TheByteAttic/Hazeltine-1420-CharGen-Firmware/images/README.md

# Images

Photos used in the READMEs. All of the author's terminal (Hazeltine 1420, 1979 board).

| File | Shows |
|---|---|
| `terminal-board-overview.jpg` | the complete logic board after restoration, keyboard in front |
| `adapters-installed.jpg` | the two character-generator adapters in U25/U26, seen from above |
| `adapters-installed-angle.jpg` | the same, at an angle, with the firmware ROMs and the CPU below them |
| `adapters-top.jpg` | the two assembled adapters, EEPROM side (rev A boards, jumpers bridged) |
| `adapters-bottom.jpg` | the two assembled adapters, logic side |
| `boards-as-delivered.jpg` | bare boards from JLCPCB next to assembled ones |
| `original-p8049-and-roms.jpg` | the original Intel P8049 CPU with the replacement 2716 EPROMs in U10/U11 |
| `cpu-upd8749hd.jpg` | the NEC uPD8749HD fitted as CPU, programmed with the 8049 image |
