TheByteAttic/Hazeltine-1420-CharGen-Firmware/H1420-chargen-adapter/hardware/images/README.md

# Images

All generated from the manufacturing data, not from a CAD screenshot.

| File | View |
|---|---|
| `render-U26-upper-top.png`, `render-U26-upper-bottom.png` | U26-upper board as manufactured, top and bottom (bottom seen from below), drill holes black |
| `render-U25-lower-top.png`, `render-U25-lower-bottom.png` | same for the U25-lower board |
| `tracks-*-top-layer.png`, `tracks-*-bottom-layer.png` | one copper layer at a time, without the ground pour, for following individual nets |
| `preview-U26-upper.png`, `preview-U25-lower.png` | layout overview with reference designators |
