TheByteAttic/Hazeltine-1420-CharGen-Firmware/H1420-chargen-adapter/hardware/schematic.pdf

Hazeltine 1420 character-generator adapter, rev B (replaces DM8678 / DM86S64 at U25 / U26)

net-label schematic: pins carrying the same label are connected. Two board variants (U26 upper / U25 lower) share this circuit.

P1 plug into DM8678 / DM86S64 socket (U25 / U26)

ADR2 | 1 A2/A3
ADR1 | 2 A1/A2
ADR0 | 3 A0/A1
ALC | 4 ADDR LATCH
nCLR | 5 /CLEAR
LCLK | 6 LINE CLOCK
CC | 7 CLOCK CTRL
GND | 8 GND
VCC 16 | VCC
A3/A4 15 | ADR3
A4/A5 14 | ADR4
A5/A6 13 | ADR5
A7|OUT 12 | PIN12
OUT|/OE 11 | PIN11
/LOAD 10 | nLD
DOT CLOCK 9 | DCLK

pin 11 = video OUT, pin 12 = A7 / enable, active low (same on both chips, measured)

U1 74HCT373 address latch

ADR0 | 3 D0
ADR1 | 4 D1
ADR2 | 7 D2
ADR3 | 8 D3
ADR4 | 13 D4
ADR5 | 14 D5
PIN12 | 17 D6
GND | 18 D7
ALC | 11 LE
GND | 1 /OE
GND | 10 GND
Q0 2 | LA0
Q1 5 | LA1
Q2 6 | LA2
Q3 9 | LA3
Q4 12 | LA4
Q5 15 | LA5
Q6 16 | LA7
Q7 19 | NC
VCC 20 | VCC

U2 74HCT161 line counter

LCLK | 2 CP
nCLR | 1 /MR
CC | 7 CEP
VCC | 10 CET
VCC | 9 /PE
GND | 3 D0
GND | 4 D1
GND | 5 D2
GND | 6 D3
GND | 8 GND
Q0 14 | ROW0
Q1 13 | ROW1
Q2 12 | ROW2
Q3 11 | ROW3
TC 15 | NC
VCC 16 | VCC

U5 AT28C64B font EEPROM (DIP-28 socket)

LA0 | 10 A0
LA1 | 9 A1
LA2 | 8 A2
LA3 | 7 A3
LA4 | 6 A4
LA5 | 5 A5
ROW0 | 4 A6
ROW1 | 3 A7
ROW2 | 25 A8
ROW3 | 24 A9
GND | 21 A10
GND | 23 A11
GND | 2 A12
GND | 20 /CE
GND | 22 /OE
GND | 14 GND
D0 11 | D0
D1 12 | D1
D2 13 | D2
D3 15 | D3
D4 16 | D4
D5 17 | D5
D6 18 | D6
D7 19 | NC
VPP/RDY/A15 1 | PU1
NC/A13 26 | PU26
/WE//PGM/A14 27 | PU27
VCC 28 | VCC

U3 74HCT166 dot shift register

D0 | 14 H
D1 | 12 G
D2 | 11 F
D3 | 10 E
D4 | 5 D
D5 | 4 C
D6 | 3 B
GND | 2 A
GND | 1 SER
DCLK | 7 CLK
nLD | 15 SH//LD
GND | 6 CLK INH
VCC | 9 /CLR
GND | 8 GND
QH 13 | SER
VCC 16 | VCC

U4 74HCT125 tri-state output

SER | 2 1A
LA7 | 1 /1OE
GND | 5 2A
GND | 4 /2OE
GND | 9 3A
GND | 10 /3OE
GND | 12 4A
GND | 13 /4OE
GND | 7 GND
1Y 3 | PIN11
2Y 6 | NC
3Y 8 | NC
4Y 11 | NC
VCC 14 | VCC
R1, R2, R3 | 1 kOhm 0805 | VCC -> U5 pin 1, 26, 27 | (nets PU1, PU26, PU27): keep /WE high on a 28C64,

set A13/A14/A15 high on a 27C256/27C512 (image block replicated, see build_eeprom.py)

C1..C5 | 100 nF 0805 decoupling, one per IC (VCC-GND)
Rev B: no jumpers. | Video out U4 pin 3 -> socket pin 11 (net PIN11); latched socket pin 12 (A7) -> U4 pin 1 /OE (net LA7).

(Rev A had solder jumpers JP1/JP2 for a DM86S64 pin assignment that turned out to be the same as the DM8678 one;

rev A boards are used with JP1 C-A and JP2 C-A bridged, which is exactly this wiring.)

Output enable polarity: U4 = 74HCT125 -> output active when latched pin 12 is LOW, as measured on both original chips.

If the font dump of a chip shows it outputs when pin 12 is HIGH, fit a 74HCT126 instead (same pinout, active-high enable).

Logic family: 74HCT (TTL-compatible inputs, VIH = 2.0 V). | The terminal drives the socket with 74LS outputs (VOH >= 2.7 V),
which plain 74HC (VIH = 3.5 V) would not reliably read. | Do not substitute 74HC for U1-U4.

Timing: address -> latch (74HCT373, ~25 ns) -> EEPROM (150 ns) -> 74HC166 setup: ~190 ns < 280 ns spec of the

original (t_S2). Dot clock up to 25 MHz with 74HCT166; Hazeltine 1420 dot clock is below 20 MHz.

Row address: the 74HC161 replaces the on-chip mod-16 line counter (CP = line clock, CEP = clock control,

/MR = /clear). Descender shifting of the original is baked into the EEPROM image row by row.

Shift register: /LOAD -> SH//LD; DOT CLOCK -> CLK; EEPROM D0 (first dot) -> H ... D6 -> B; A and SER = 0,

so the output goes low after the 7 dots exactly like the original.

Copyright (c) 2026 by The Byte Attic B.V.
