TheByteAttic/Hazeltine-1420-CharGen-Firmware/H1420-Bitsavers-firmware/h1420_descr.jpg

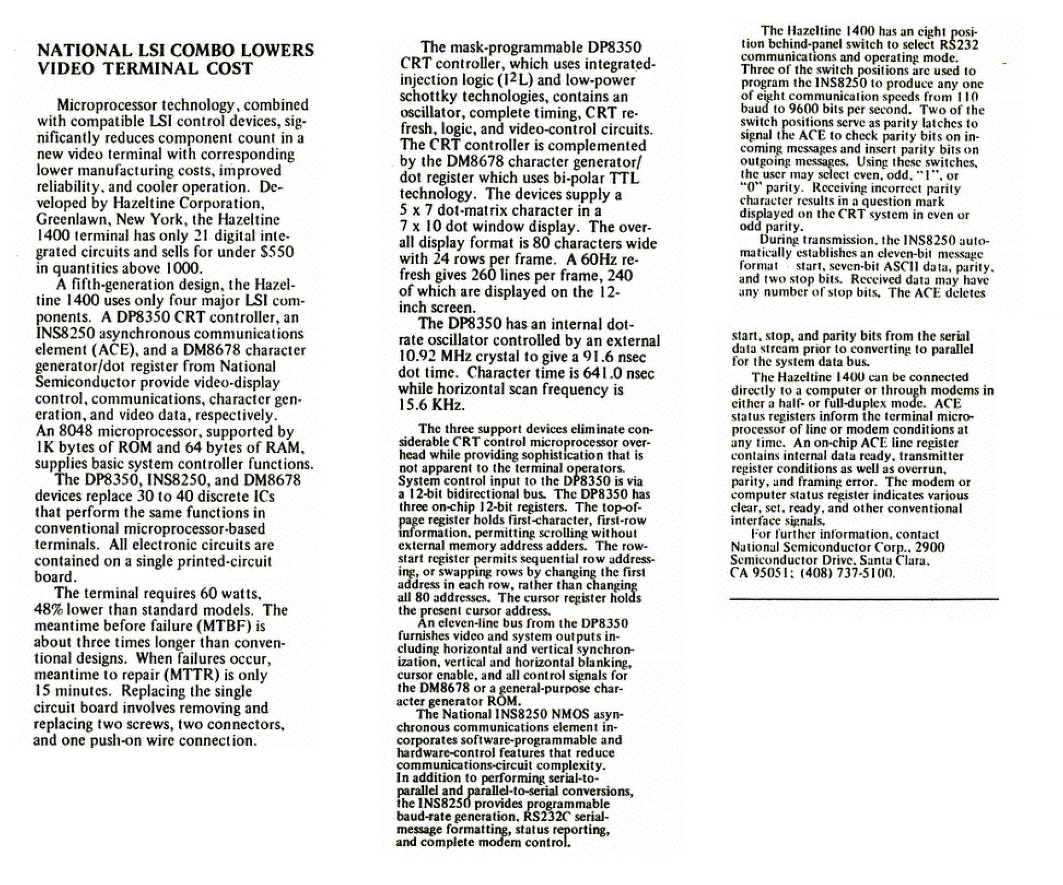
H1420-Bitsavers-firmware/h1420_descr.jpg
