TheByteAttic/Hazeltine-1420-CharGen-Firmware/H1420-Bitsavers-firmware/pcb3.jpg

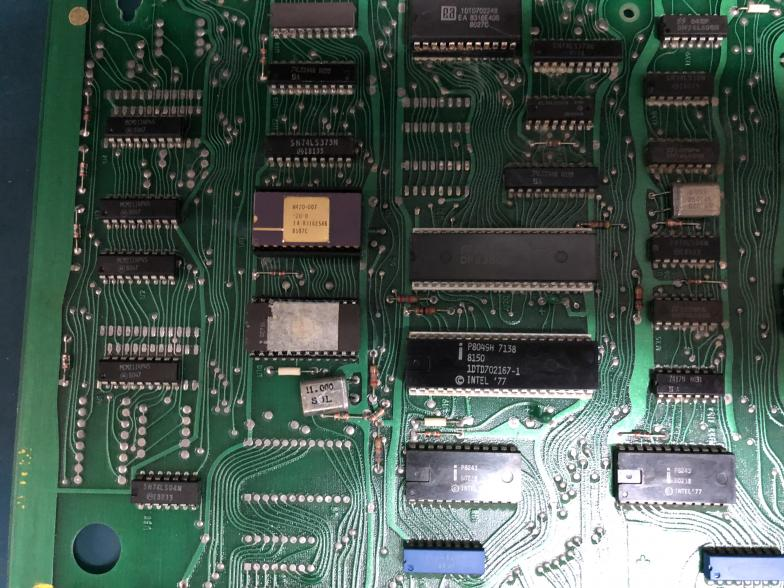
H1420-Bitsavers-firmware/pcb3.jpg
