TheByteAttic/Hazeltine-1420-CharGen-Firmware/H1420-chargen-adapter/hardware/images/preview-U26-upper.png

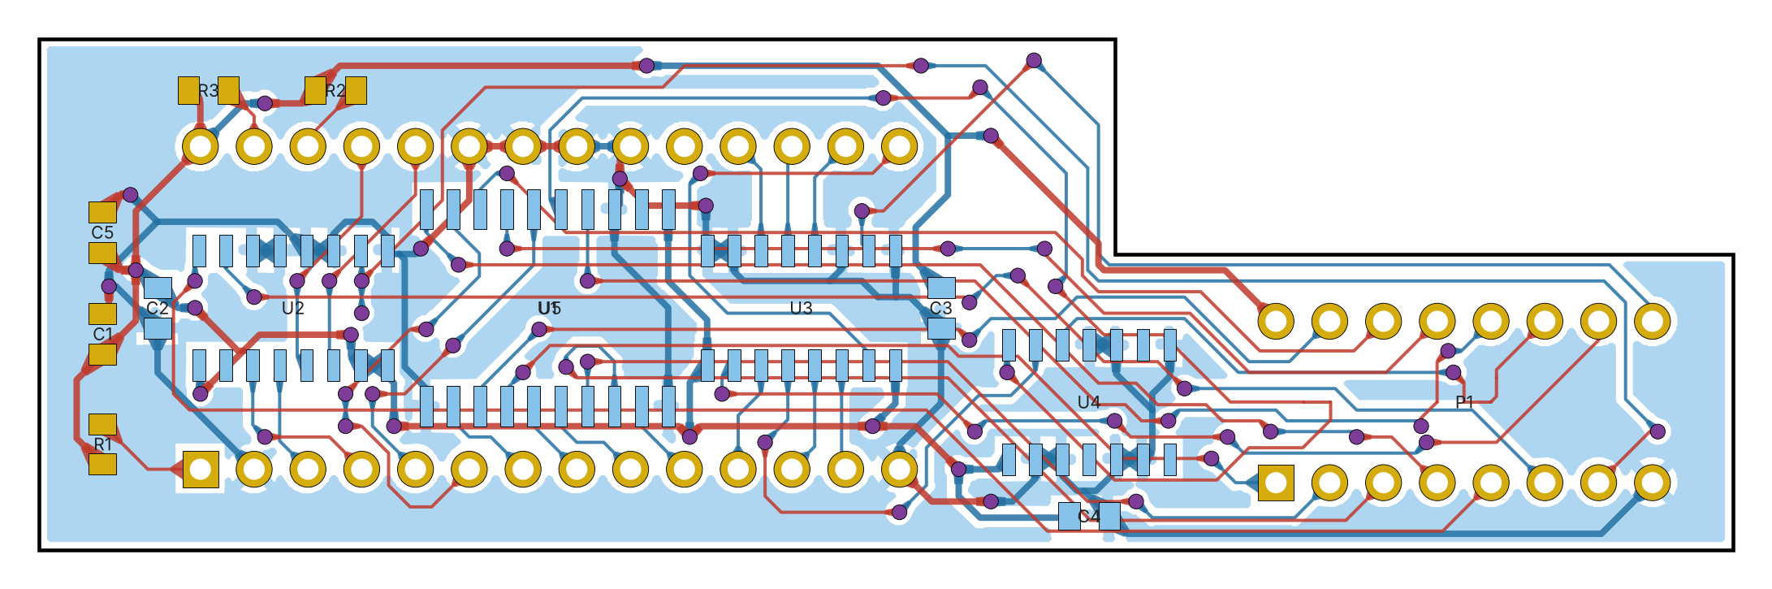
H1420-chargen-adapter/hardware/images/preview-U26-upper.png
