TheByteAttic/Hazeltine-1420-CharGen-Firmware/H1420-chargen-adapter/hardware/images/render-U26-upper-bottom.png

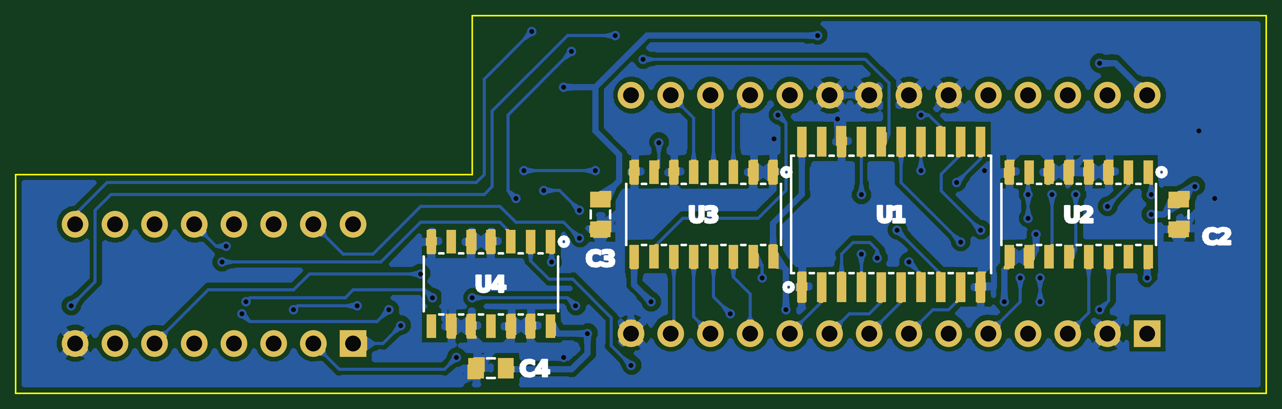
H1420-chargen-adapter/hardware/images/render-U26-upper-bottom.png
