TheByteAttic/Hazeltine-1420-CharGen-Firmware/H1420-chargen-adapter/hardware/images/tracks-U26-upper-top-layer.png

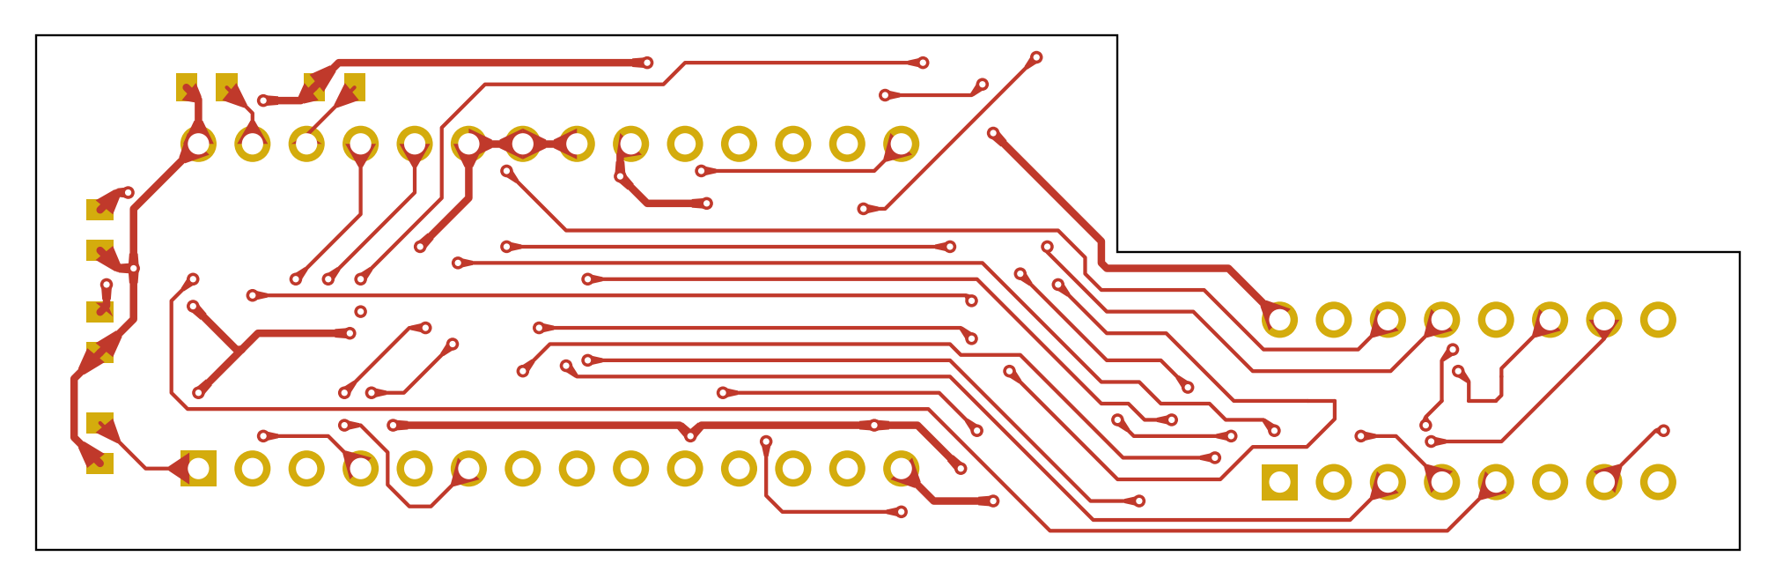
H1420-chargen-adapter/hardware/images/tracks-U26-upper-top-layer.png
