TheByteAttic/Hazeltine-1420-CharGen-Firmware/H1420-chargen-adapter/hardware/kicad/h1420-chargen-U26-upper.kicad_pcb

## KiCad design H1420-chargen-adapter/hardware/kicad/h1420-chargen-U26-upper.kicad_pcb (2026-11-02)

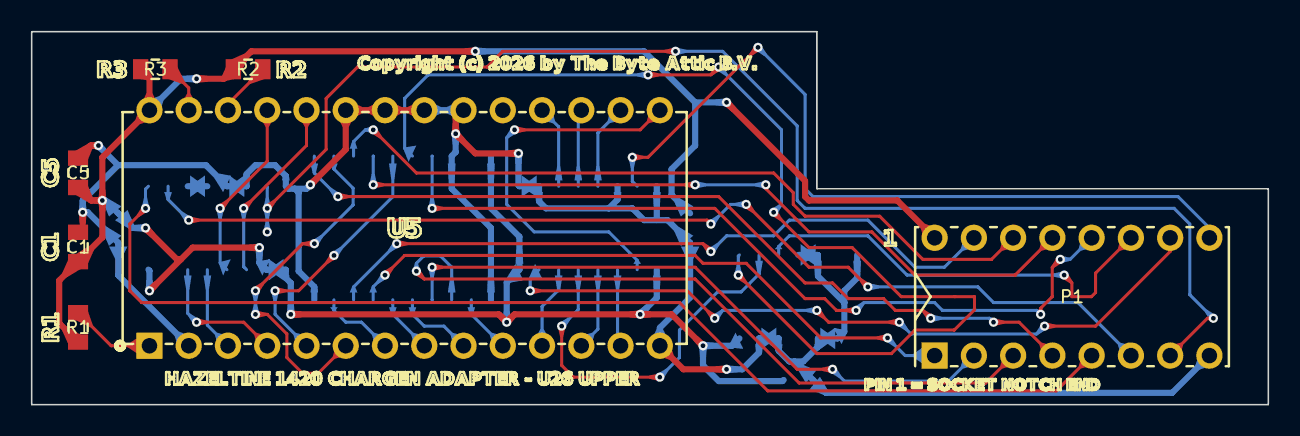
[picture p23: board h1420-chargen-U26-upper.kicad_pcb from above]

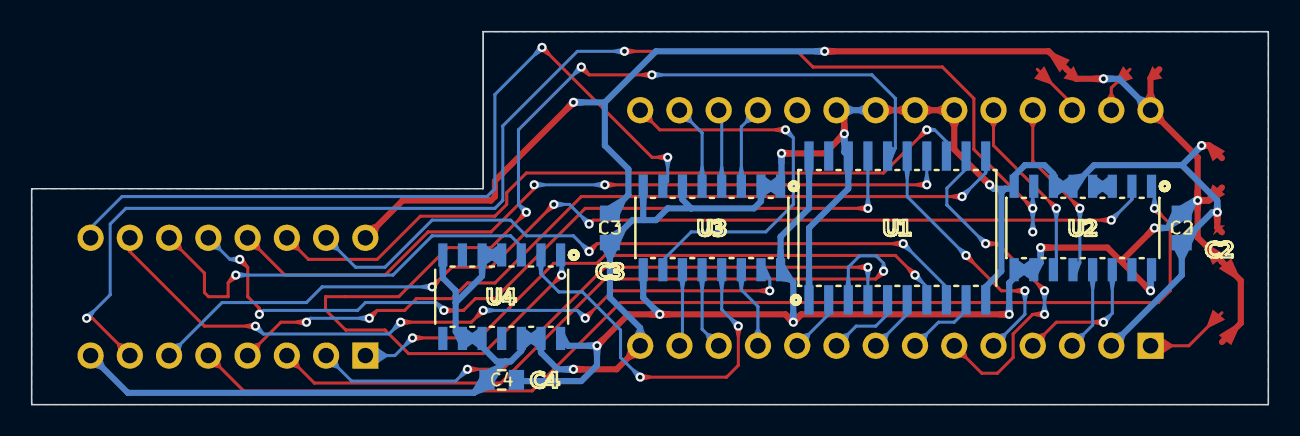
[picture p24: board h1420-chargen-U26-upper.kicad_pcb from below]

Board: 2 copper layers, 80.0 x 24.1 mm, 14 parts (7 on the bottom side), 38 nets.

Parts:
C1: 100nF; C1
C2: 100nF; C2
C3: 100nF; C3
C4: 100nF; C4
C5: 100nF; C5
P1: DIP-16 plug; P1
R1: 1k; R1
R2: 1k; R2
R3: 1k; R3
U1: 74HCT373D; U1
U2: 74HCT161D; U2
U3: 74HCT166D; U3
U4: 74HCT125D; U4
U5: AT28C64B-15PU; U5

Connections:
ADR0: P1.3, U1.3
ADR1: P1.2, U1.4
ADR2: P1.1, U1.7
ADR3: P1.15, U1.8
ADR4: P1.14, U1.13
ADR5: P1.13, U1.14
ALC: P1.4, U1.11
CC: P1.7, U2.7
D0: U3.14, U5.11
D1: U3.12, U5.12
D2: U3.11, U5.13
D3: U3.10, U5.15
D4: U3.5, U5.16
D5: U3.4, U5.17
D6: U3.3, U5.18
DCLK: P1.9, U3.7
GND: C1.2, C2.2, C3.2, C4.2, C5.2, P1.8, U1.1, U1.10, U1.18, U2.3, U2.4, U2.5, U2.6, U2.8, U3.1, U3.2, U3.6, U3.8, U4.4, U4.5, U4.7, U4.9, U4.10, U4.12, U4.13, U5.2, U5.14, U5.20, U5.21, U5.22, U5.23
LA0: U1.2, U5.10
LA1: U1.5, U5.9
LA2: U1.6, U5.8
LA3: U1.9, U5.7
LA4: U1.12, U5.6
LA5: U1.15, U5.5
LA7: U1.16, U4.1
LCLK: P1.6, U2.2
PIN11: P1.11, U4.3
PIN12: P1.12, U1.17
PU1: R1.2, U5.1
PU26: R2.2, U5.26
PU27: R3.2, U5.27
ROW0: U2.14, U5.4
ROW1: U2.13, U5.3
ROW2: U2.12, U5.25
ROW3: U2.11, U5.24
SER: U3.13, U4.2
VCC: C1.1, C2.1, C3.1, C4.1, C5.1, P1.16, R1.1, R2.1, R3.1, U1.20, U2.9, U2.10, U2.16, U3.9, U3.16, U4.14, U5.28
nCLR: P1.5, U2.1
nLD: P1.10, U3.15
