TheByteAttic/Hazeltine-1420-CharGen-Firmware/(commit log)

2026-11-02 Reorganise repository: root README, firmware README, photos, rev B adapter package
    - Root README describing both subprojects and how the 1420's CPU, ROMs and
    character generators relate.
    - README for H1420-Bitsavers-firmware (file formats, what goes where).
    - images/ with photos of the boards and the installation, used by the READMEs.
    - Adapter docs README lists the added datasheets; .gitignore moved to the root.
    Claude-Session: https://claude.ai/code/session_011HoGPaAqnT65U6cRVrdtFJ
2026-11-02 Replace board overview photo
    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
2026-11-02 Root README: use the repository copy of the board photo
    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
2026-11-02 Update LICENSE to include 'Materials' terminology
